board707/Fok_Gyem_flipdot_clock/(commit log)

2024-04-13 Add pcb images
2024-04-18 Fix define error. Add comments and copyrights
    [Fok_EM_test.ino]
